LuZening/Flasher32/PCB/flasher32/flasher32.kicad_pcb

## KiCad design PCB/flasher32/flasher32.kicad_pcb (2022-02-09)

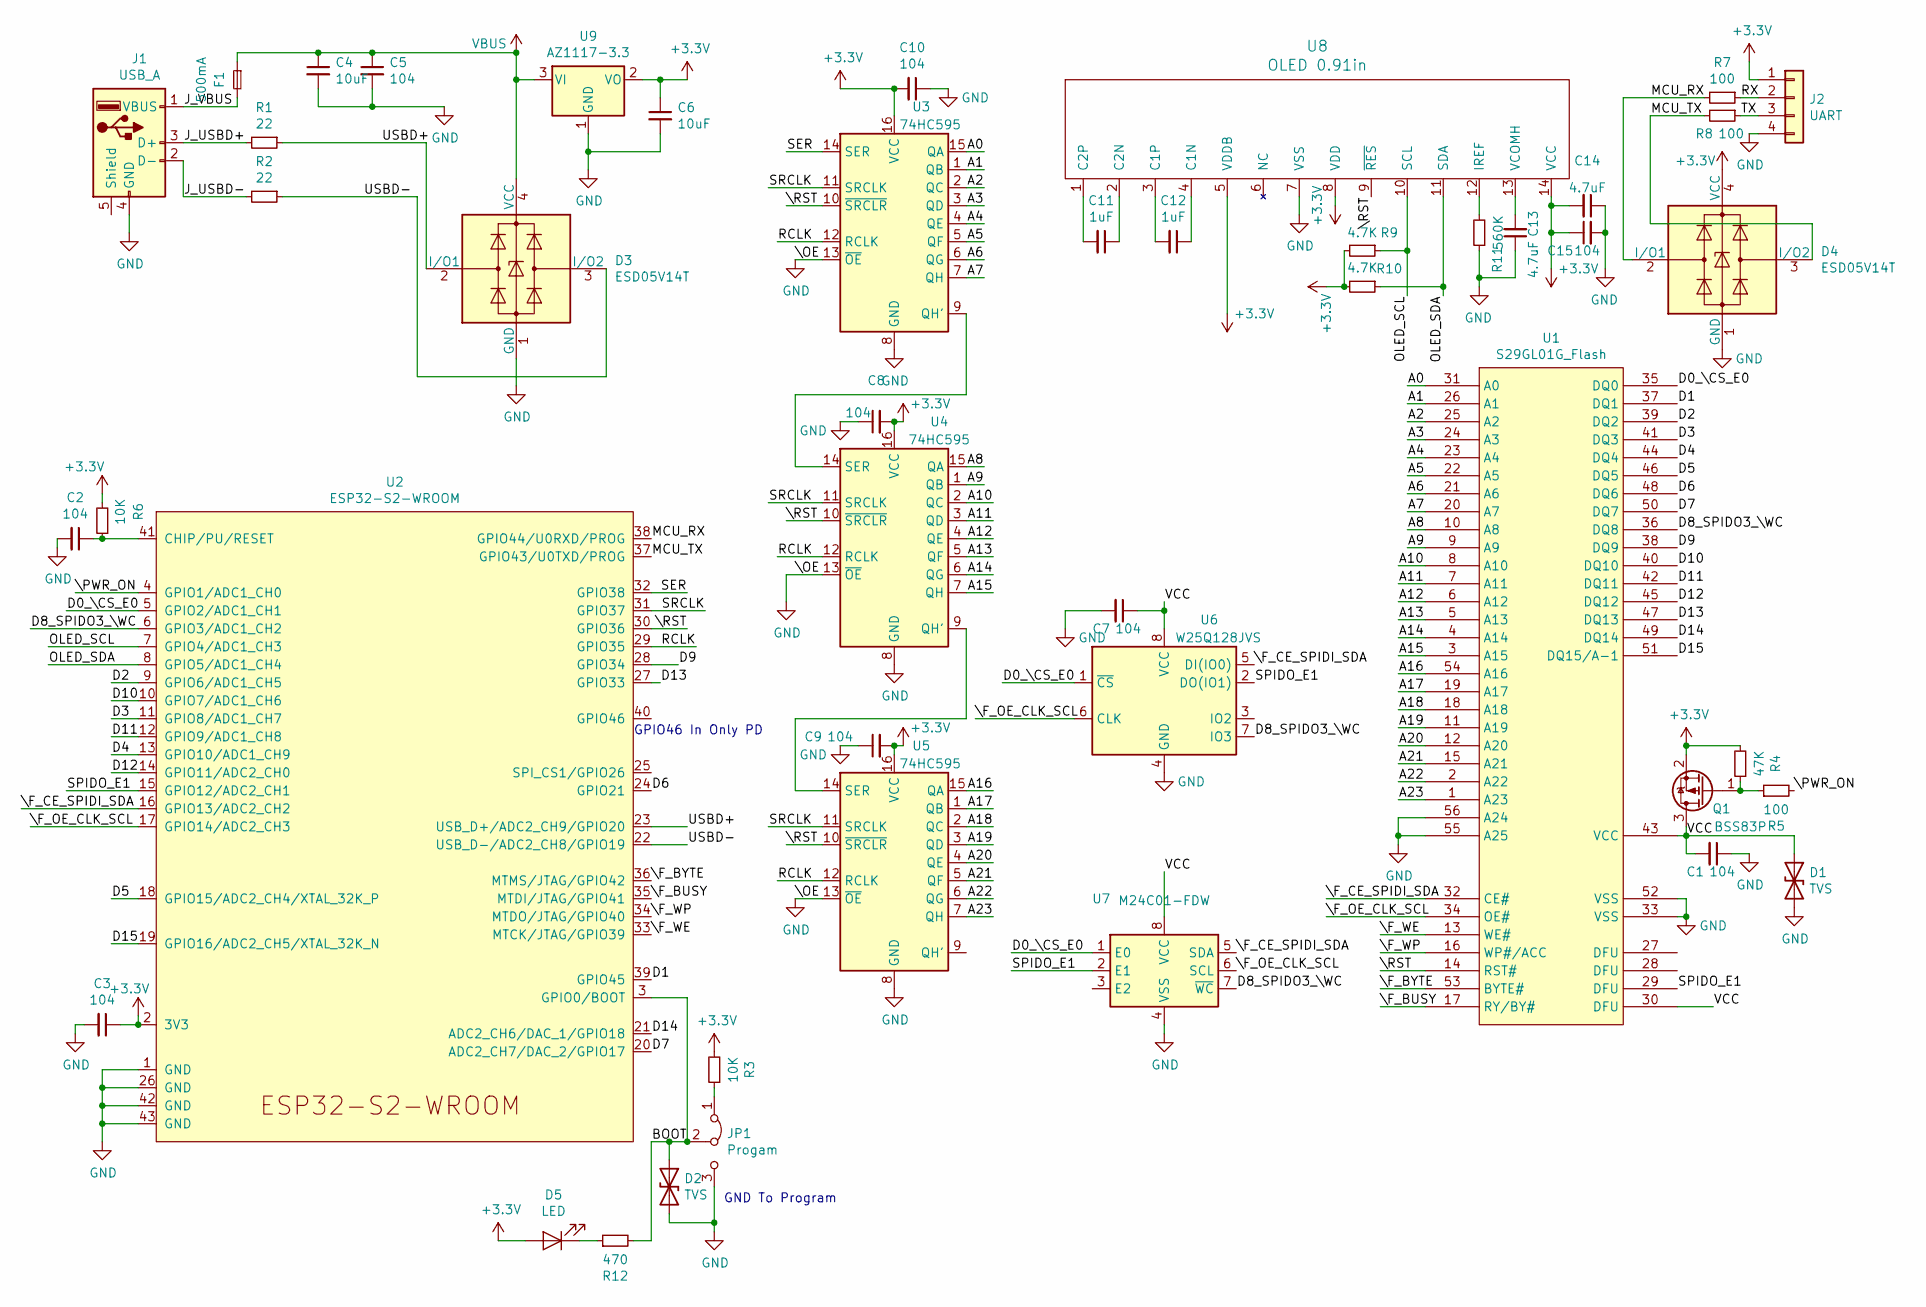
[picture p1: schematic flasher32.sch]

Parts:
C1, C2, C3, C5, C7, C8, C9, C10, C15: 104; 0805_C
C4, C6: 10uF; 0805_C
C11, C12: 1uF; 0805_C
C13, C14: 4.7uF; 0805_C
D1, D2: TVS; SOD-123
D3, D4: ESD05V14T; SOT-143
D5: LED; 0805_LED_S1
F1: 500mA; 0805_L
J1: USB_A; USB_Male_A_UP2-AH-1-TH
J2: UART; PinSocket_1x04_P2.54mm_Vertical
JP1: Progam; PinSocket_1x03_P2.54mm_Vertical
Q1: BSS83P; SOT-23
R1, R2: 22; 0805_R
R3, R6: 10K; 0805_R
R4: 47K; 0805_R
R5, R7, R8: 100; 0805_R
R9, R10: 4.7K; 0805_R
R11: 560K; 0805_R
R12: 470; 0805_R
U1: S29GL01G_Flash; TSOP56_Flasher_Socket
U2: ESP32-S2-WROOM
U3, U4, U5: 74HC595; SOP-16_150MIL
U6: W25Q128JVS; SOIC-8_5.23x5.23mm_P1.27mm
U7: M24C01-FDW; TSSOP-8_4.4x3mm_P0.65mm
U8: OLED 0.91in; SSD1306_OLED-0.91-128x32_Fold
U9: AZ1117-3.3; SOT-223

Connections:
+3V3: C3.1, C6.1, C8.2, C9.2, C10.2, C14.2, C15.1, D4.4 (VCC), D5.A, J2.1, Q1.2 (S), R3.2, R4.2, R6.2, R9.2, R10.2, U2.2 (3V3), U3.16 (VCC), U4.16 (VCC), U5.16 (VCC), U8.5 (VDDB), U8.8 (VDD), U8.14 (VCC), U9.2 (VO); also elsewhere on the board
/A0: U1.31 (A0), U3.15 (QA)
/A1: U1.26 (A1), U3.1 (QB)
/A2: U1.25 (A2), U3.2 (QC)
/A3: U1.24 (A3), U3.3 (QD)
/A4: U1.23 (A4), U3.4 (QE)
/A5: U1.22 (A5), U3.5 (QF)
/A6: U1.21 (A6), U3.6 (QG)
/A7: U1.20 (A7), U3.7 (QH)
/A8: U1.10 (A8), U4.15 (QA)
/A9: U1.9 (A9), U4.1 (QB)
/A10: U1.8 (A10), U4.2 (QC)
/A11: U1.7 (A11), U4.3 (QD)
/A12: U1.6 (A12), U4.4 (QE)
/A13: U1.5 (A13), U4.5 (QF)
/A14: U1.4 (A14), U4.6 (QG)
/A15: U1.3 (A15), U4.7 (QH)
/A16: U1.54 (A16), U5.15 (QA)
/A17: U1.19 (A17), U5.1 (QB)
/A18: U1.18 (A18), U5.2 (QC)
/A19: U1.11 (A19), U5.3 (QD)
/A20: U1.12 (A20), U5.4 (QE)
/A21: U1.15 (A21), U5.5 (QF)
/A22: U1.2 (A22), U5.6 (QG)
/A23: U1.1 (A23), U5.7 (QH)
/BOOT: D2.1 (A1), JP1.2 (C), R12.2, U2.3 (GPIO0/BOOT)
/D0_\CS_E0: U1.35 (DQ0), U2.5 (GPIO2/ADC1_CH1), U6.1 (~CS), U7.1 (E0)
/D1: U1.37 (DQ1), U2.39 (GPIO45)
/D2: U1.39 (DQ2), U2.9 (GPIO6/ADC1_CH5)
/D3: U1.41 (DQ3), U2.11 (GPIO8/ADC1_CH7)
/D4: U1.44 (DQ4), U2.13 (GPIO10/ADC1_CH9)
/D5: U1.46 (DQ5), U2.18 (GPIO15/ADC2_CH4/XTAL_32K_P)
/D6: U1.48 (DQ6), U2.24 (GPIO21)
/D7: U1.50 (DQ7), U2.20 (ADC2_CH7/DAC_2/GPIO17)
/D8_SPIDO3_\WC: U1.36 (DQ8), U2.6 (GPIO3/ADC1_CH2), U6.7 (IO3), U7.7 (~WC)
/D9: U1.38 (DQ9), U2.28 (GPIO34)
/D10: U1.40 (DQ10), U2.10 (GPIO7/ADC1_CH6)
/D11: U1.42 (DQ11), U2.12 (GPIO9/ADC1_CH8)
/D12: U1.45 (DQ12), U2.14 (GPIO11/ADC2_CH0)
/D13: U1.47 (DQ13), U2.27 (GPIO33)
/D14: U1.49 (DQ14), U2.21 (ADC2_CH6/DAC_1/GPIO18)
/D15: U1.51 (DQ15/A-1), U2.19 (GPIO16/ADC2_CH5/XTAL_32K_N)
/J_USBD+: J1.3 (D+), R1.2
/J_USBD-: J1.2 (D-), R2.2
/J_VBUS: F1.2, J1.1 (VBUS)
/MCU_RX: D4.2 (I/O1), R7.2, U2.38 (GPIO44/U0RXD/PROG)
/MCU_TX: D4.3 (I/O2), R8.2, U2.37 (GPIO43/U0TXD/PROG)
/OLED_SCL: R9.1, U2.7 (GPIO4/ADC1_CH3), U8.10 (SCL)
/OLED_SDA: R10.1, U2.8 (GPIO5/ADC1_CH4), U8.11 (SDA)
/RCLK: U2.29 (GPIO35), U3.12 (RCLK), U4.12 (RCLK), U5.12 (RCLK)
/RX: J2.2, R7.1; also elsewhere on the board
/SER: U2.32 (GPIO38), U3.14 (SER)
/SPIDO_E1: U1.29 (DFU), U2.15 (GPIO12/ADC2_CH1), U6.2 (DO(IO1)), U7.2 (E1)
/SRCLK: U2.31 (GPIO37), U3.11 (SRCLK), U4.11 (SRCLK), U5.11 (SRCLK)
/TX: J2.3, R8.1; also elsewhere on the board
/USBD+: D3.2 (I/O1), R1.1, U2.23 (USB_D+/ADC2_CH9/GPIO20)
/USBD-: D3.3 (I/O2), R2.1, U2.22 (USB_D-/ADC2_CH8/GPIO19)
/VCC: C1.2, C7.1, D1.1 (A1), Q1.3 (D), U1.30 (DFU), U1.43 (VCC), U6.8 (VCC), U7.8 (VCC)
/\F_BUSY: U1.17 (RY/BY#), U2.35 (MTDI/JTAG/GPIO41)
/\F_BYTE: U1.53 (BYTE#), U2.36 (MTMS/JTAG/GPIO42)
/\F_CE_SPIDI_SDA: U1.32 (CE#), U2.16 (GPIO13/ADC2_CH2), U6.5 (DI(IO0)), U7.5 (SDA)
/\F_OE_CLK_SCL: U1.34 (OE#), U2.17 (GPIO14/ADC2_CH3), U6.6 (CLK), U7.6 (SCL)
/\F_WE: U1.13 (WE#), U2.33 (MTCK/JTAG/GPIO39)
/\F_WP: U1.16 (WP#/ACC), U2.34 (MTDO/JTAG/GPIO40)
/\PWR_ON: R5.2, U2.4 (GPIO1/ADC1_CH0)
/\RST: U1.14 (RST#), U2.30 (GPIO36), U3.10 (~SRCLR), U4.10 (~SRCLR), U5.10 (~SRCLR), U8.9 (~RES)
GND: C1.1, C2.2, C3.2, C4.2, C5.2, C6.2, C7.2, C8.1, C9.1, C10.1, C13.1, C14.1, C15.2, D1.2 (A2), D2.2 (A2), D3.1 (GND), D4.1 (GND), J1.4 (GND), J2.4, JP1.3 (B), R11.1, U1.33 (VSS), U1.52 (VSS), U1.55 (A25), U1.56 (A24), U2.1 (GND), U2.26 (GND), U2.42 (GND), U2.43 (GND), U3.8 (GND), U3.13 (~OE), U4.8 (GND), U4.13 (~OE), U5.8 (GND), U5.13 (~OE), U6.4 (GND), U7.4 (VSS), U8.7 (VSS), U9.1 (GND); also elsewhere on the board
unnamed: C2.1, R6.1, U2.41 (CHIP/PU/RESET)
unnamed: C11.1, U8.2 (C2N)
unnamed: C11.2, U8.1 (C2P)
unnamed: C12.1, U8.4 (C1N)
unnamed: C12.2, U8.3 (C1P)
unnamed: C13.2, U8.13 (VCOMH)
unnamed: D5.K, R12.1
unnamed: JP1.1 (A), R3.1
unnamed: Q1.1 (G), R4.1, R5.1
unnamed: R11.2, U8.12 (IREF)
unnamed: U3.9 (QH'), U4.14 (SER)
unnamed: U4.9 (QH'), U5.14 (SER)
VBUS: C4.1, C5.1, D3.4 (VCC), F1.1, U9.3 (VI)

Notes on the sheet:
GND To Program
GPIO46 In Only PD

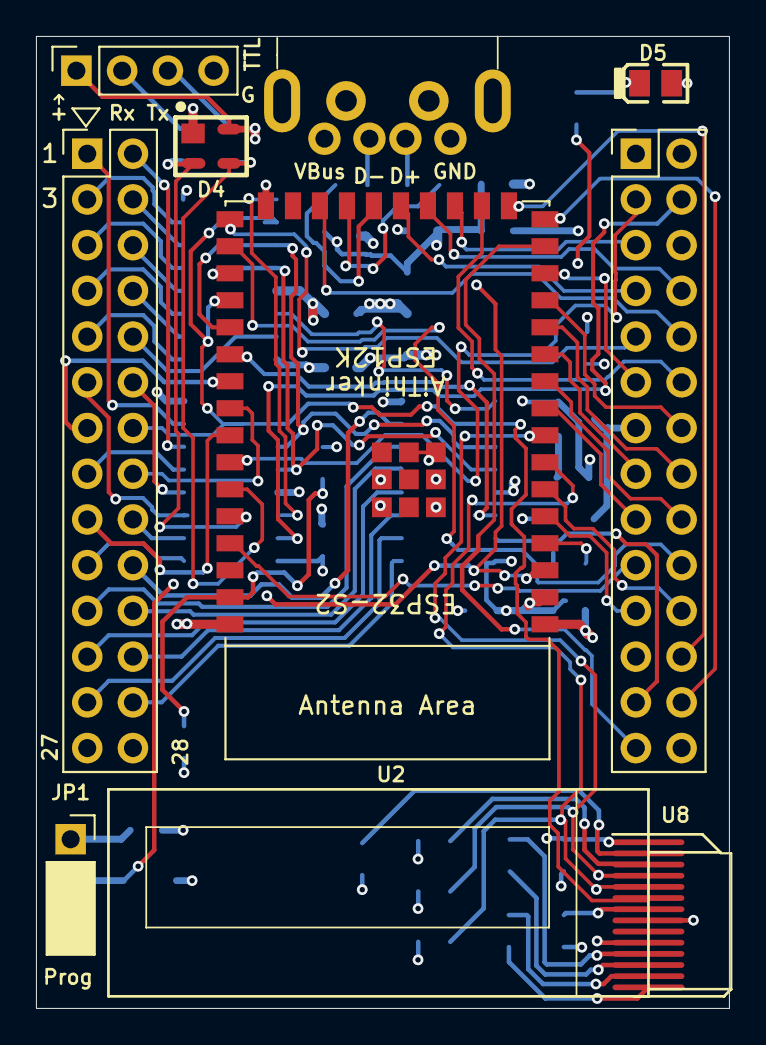
[picture p2: board flasher32.kicad_pcb from above]

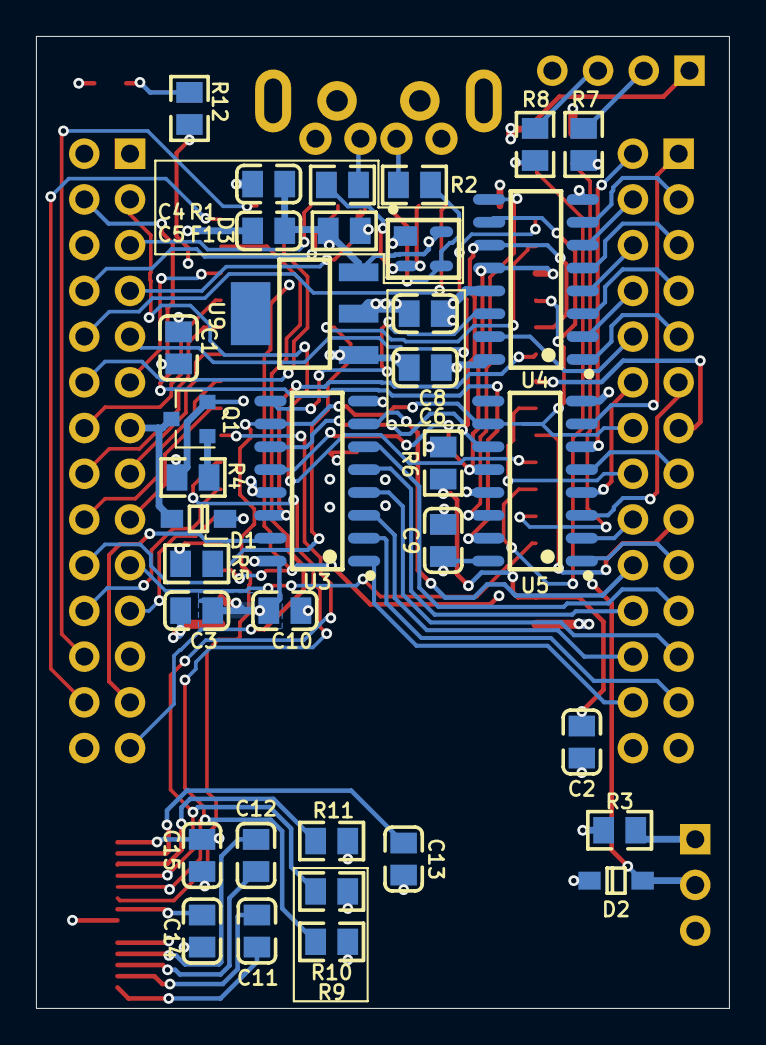
[picture p3: board flasher32.kicad_pcb from below]

Board: 4 copper layers, 38.5 x 54.0 mm, 43 parts (35 on the bottom side), 80 nets.

Other parts of the board:
TTL: UART; PinSocket_1x04_P2.54mm_Vertical

Their connections:
+3V3: TTL.1; also elsewhere on the board
/RX: TTL.2; also elsewhere on the board
/TX: TTL.3; also elsewhere on the board
GND: TTL.4; also elsewhere on the board
